edwardatki/Quectowatch/STM32WB55/Frontlight/jlcpcb/production_files/BOM-Frontlight.csv

Comment | Designator | Footprint | LCSC
LED | D1,D2 | LED_0603_1608Metric | C2290
27R | R1 | R_0603_1608Metric | C23140
