edwardatki/Quectowatch/STM32WB55/cover.step

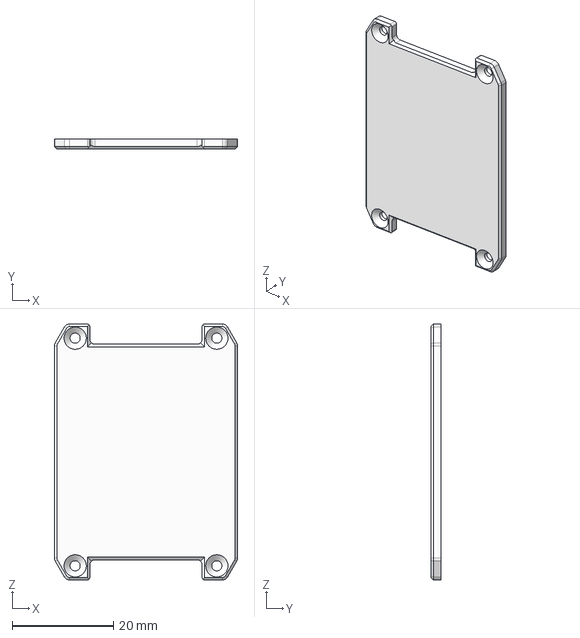
[picture p1: CAD file, 2024-08-24]
STM32WB55/cover.step
36.2 x 2.00 x 50.6 mm
