edwardatki/Quectowatch/STM32WB55/Frontlight/Frontlight.step

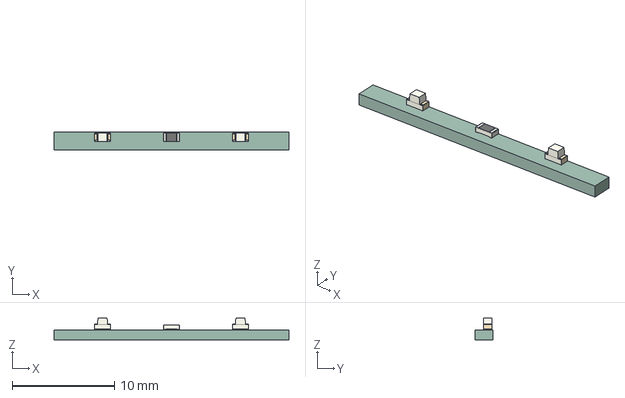
[picture p2: CAD file, 2024-08-17]
STM32WB55/Frontlight/Frontlight.step
23.0 x 1.75 x 2.13 mm
PCB
