edwardatki/Quectowatch/STM32WB55/Hardware/Hardware.step

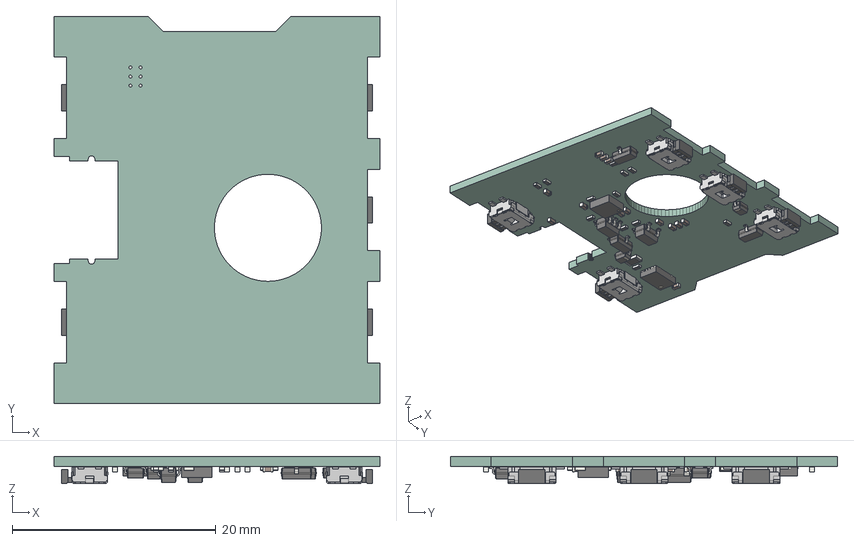
[picture p3: CAD file, 2024-08-17]
STM32WB55/Hardware/Hardware.step
32.0 x 38.0 x 2.68 mm
PCB
