edwardatki/Quectowatch/STM32WB55/case.step

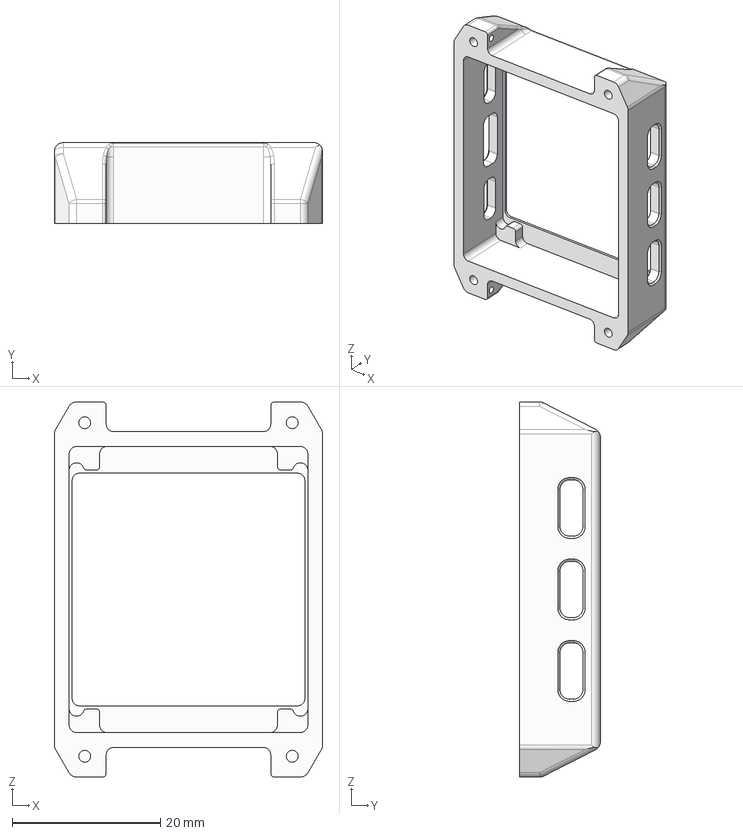
[picture p4: CAD file, 2024-08-24]
STM32WB55/case.step
36.2 x 10.9 x 50.6 mm
