edwardatki/Quectowatch/STM32WB55/button.step

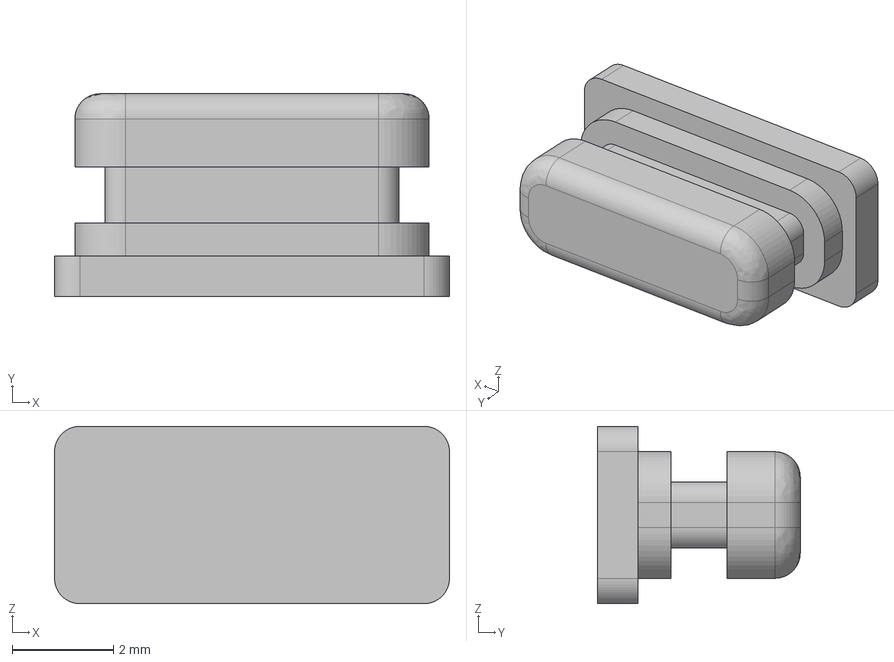
[picture p5: CAD file, 2024-08-17]
STM32WB55/button.step
7.80 x 4.00 x 3.50 mm
