edwardatki/Quectowatch/NRF52/Hardware/Hardware.step

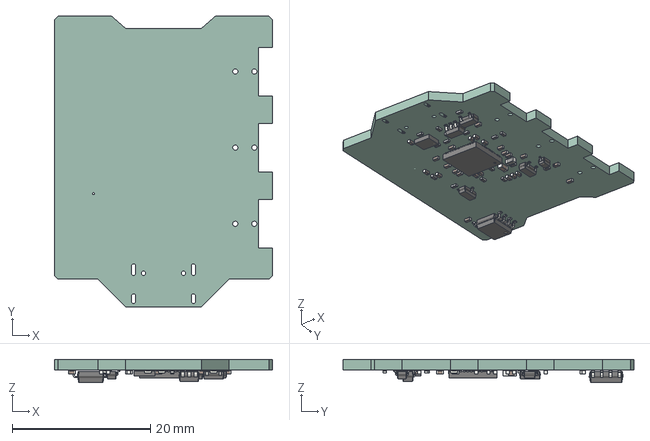
[picture p6: CAD file, 2024-04-19, an earlier design]
NRF52/Hardware/Hardware.step
31.5 x 42.0 x 3.38 mm
PCB
