edwardatki/Quectowatch/STM32WB55/drawing.pdf

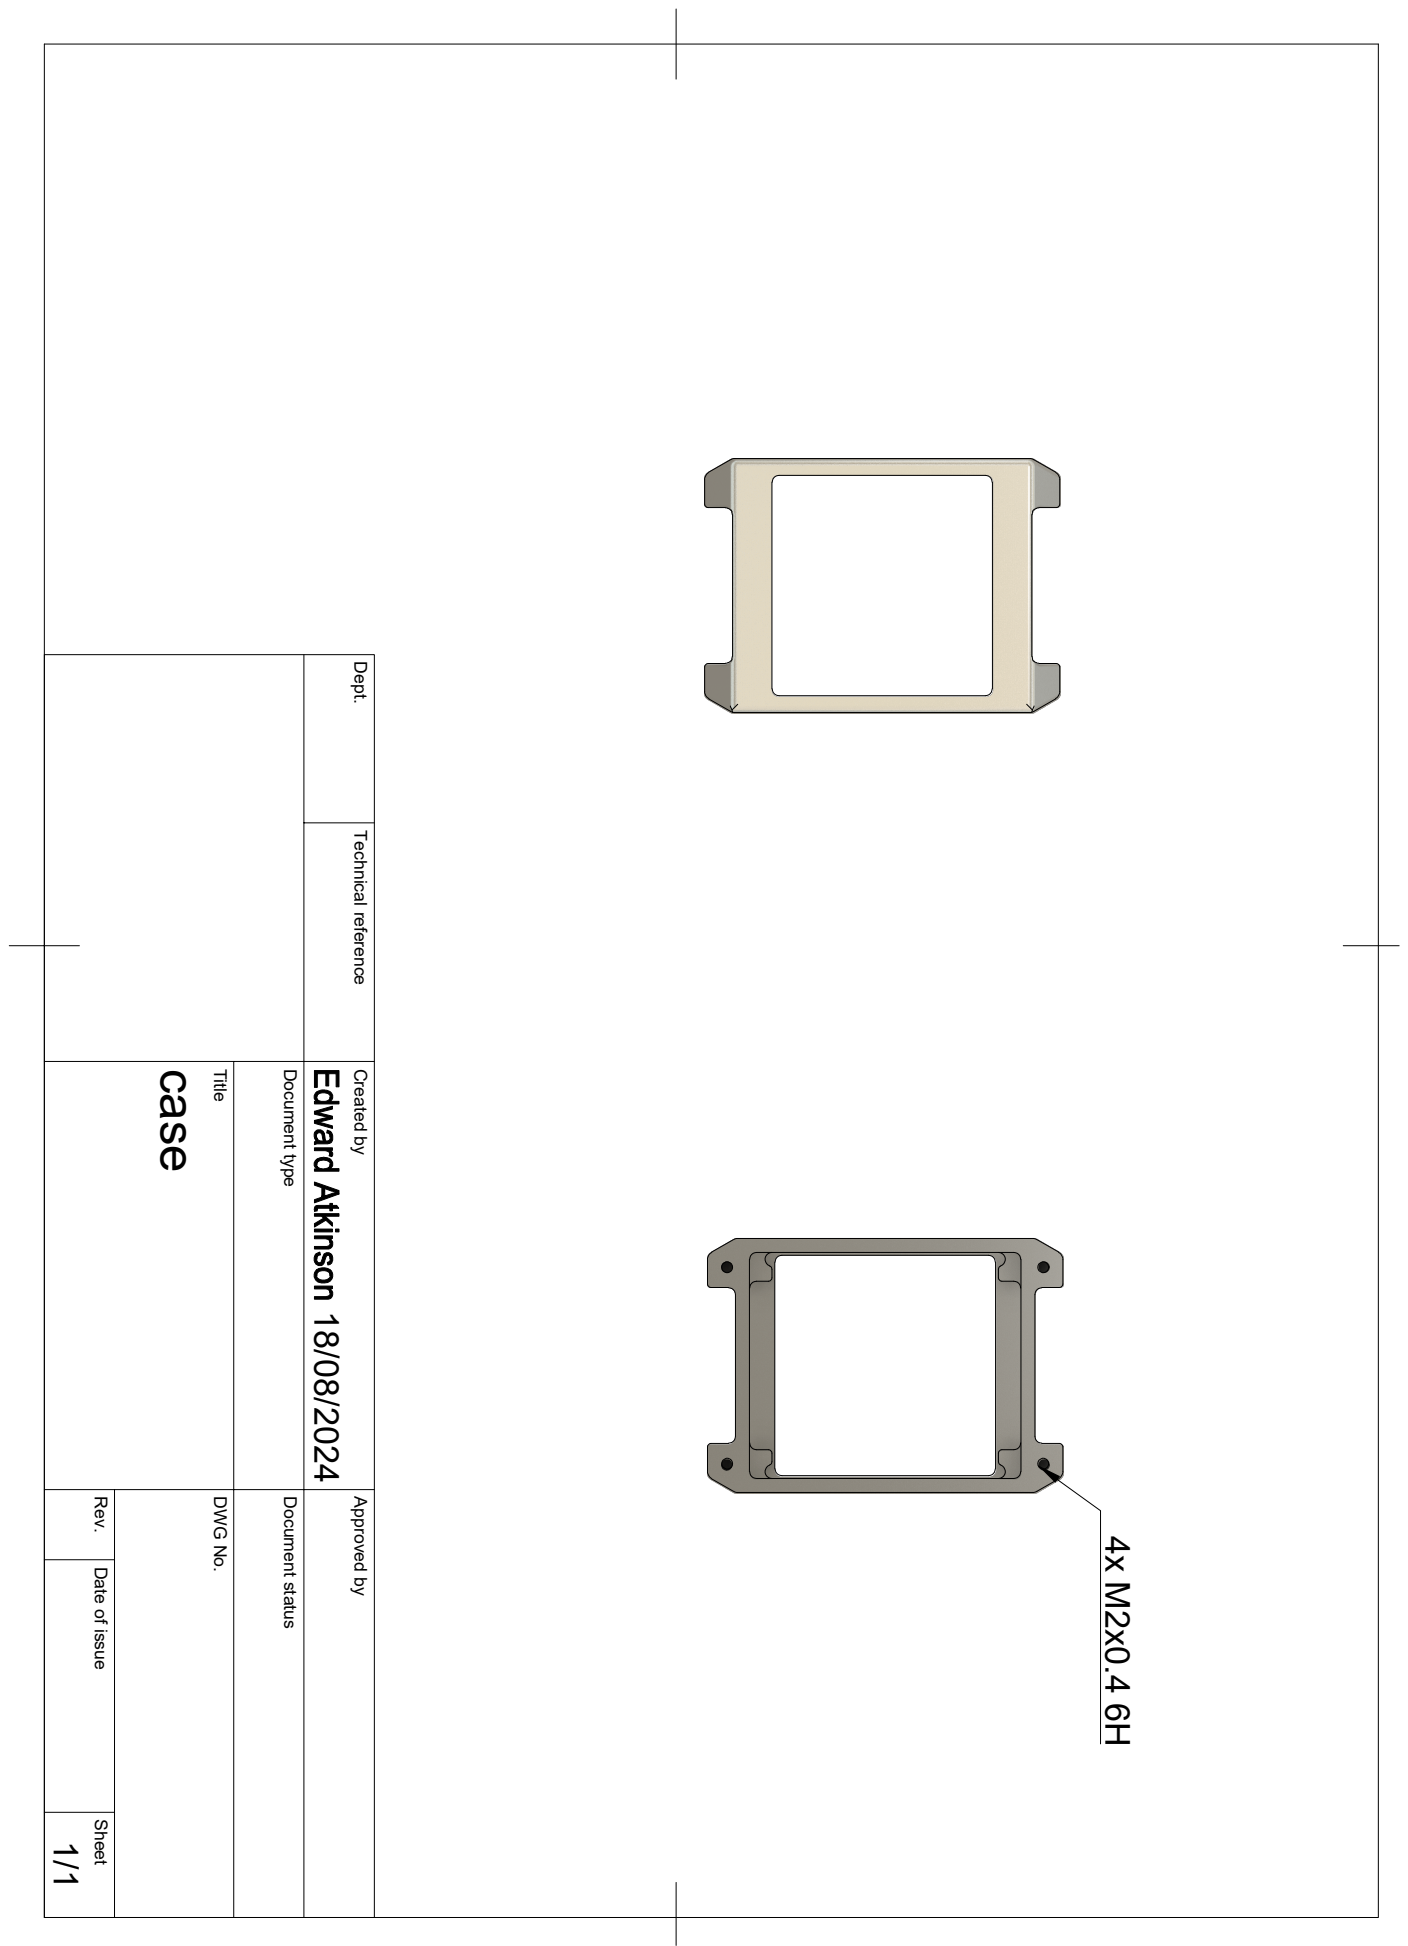
[picture p7: page 1]

Dept. Technical reference Created by Approved by Title DWG No. Document type Document status Rev. Date of issue Sheet 18/08/2024 1/1 case 4x M2x0.4 6H
