edwardatki/Quectowatch/STM32WB55/Hardware/Hardware.kicad_pcb

## KiCad design STM32WB55/Hardware/Hardware.kicad_pcb (2024-08-17)

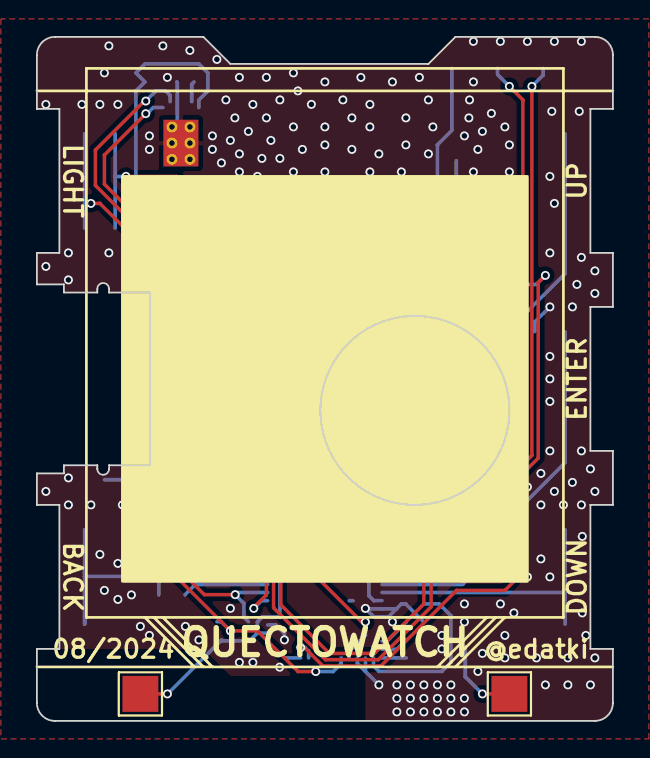
[picture p8: board STM32WB55/Hardware/Hardware.kicad_pcb from above]

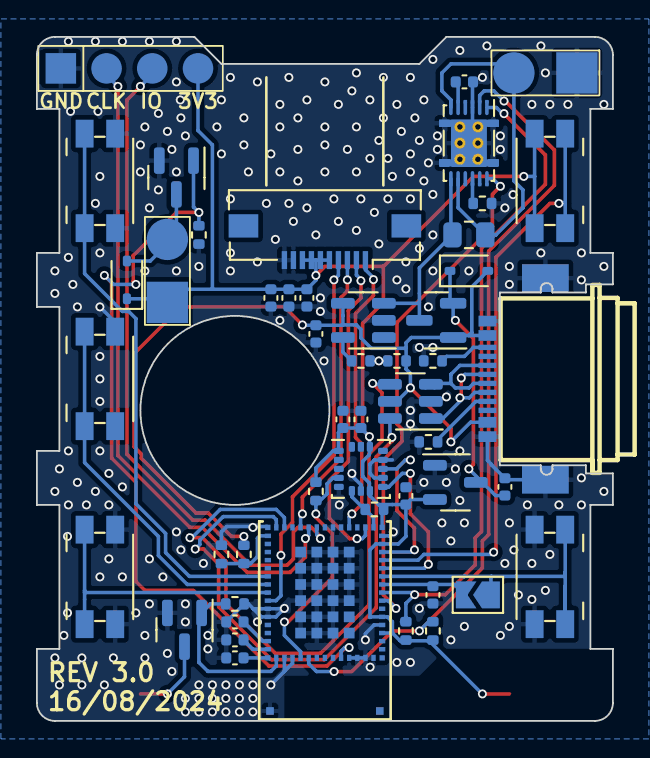
[picture p9: board STM32WB55/Hardware/Hardware.kicad_pcb from below]

Board: 2 copper layers, 32.0 x 38.0 mm, 51 parts (49 on the bottom side), 42 nets.

Parts:
C1, C7, C11: 100nF; C_0402_1005Metric
C2, C3, C4: 3.3pF; C_0402_1005Metric
C5: 470nF; C_0402_1005Metric
C6, C8, C9, C10, C13: 1uF; C_0402_1005Metric
C12: 10uF; C_0402_1005Metric
D1, D4: 1N5819WS; D_SOD-323
J1: USB_C_Receptacle_USB2.0; USB-C-SMD_SHOUHAN_TYPE-C-16PFS-2JCB1.2-H6.5
J2: PROG; 1x04_2.54_Pads
J3: BAT; 1x02_2.54_Pads
J4: LCD; Molex_54548-1071_1x10-1MP_P0.5mm_Horizontal
J5: AUX; 1x02_2.54_Pads
J6: LED+; TestPoint_Pad_2.0x2.0mm
J7: LED-; TestPoint_Pad_2.0x2.0mm
JP1: Jumper_2_Open; SolderJumper-2_P1.3mm_Open_TrianglePad1.0x1.5mm
Q1: AO3401A; SOT-23
Q2, Q3: AO3400A; SOT-23
R1, R2: 5K1; R_0402_1005Metric
R3: R01 1%; R_0805_2012Metric
R4: 470R; R_0402_1005Metric
R5: 1K; R_0402_1005Metric
R6, R7, R8, R10, R13, R14: 10K; R_0402_1005Metric
R9: 3.3K; R_0402_1005Metric
R12, R15: 100K; R_0402_1005Metric
SW1, SW2, SW3, SW4, SW5: SW_Push; Panasonic_EVQPUA_EVQPUJ
U1: USBLC6-2SC6; SOT-23-6
U2: STM32WB5MMGH6TR; LCC-LGA-86_L11.0-W7.3_STM32WB5MMGH6TR
U3: BQ27441DRZR-G1A; Texas_S-PDSO-N12
U4: TP4054; SOT-23-5
U5: LIS3DH; LGA-16_3x3mm_P0.5mm_LayoutBorder3x5y
U6: XC6206P332MR; SOT-23-3

Connections:
+3V3: C7.1, C8.1, C9.1, C11.1, C12.1, C13.1, D4.1 (K), J2.4, J4.5, J4.6, J4.7, J4.8, J5.1, J6.1, R7.1, R8.1, R13.1, R14.1, SW1.2, U2.4 (VREF+), U2.6 (VDDA), U2.15 (VBAT), U2.17 (VDDA), U5.1 (VDD_IO), U5.8 (CS), U5.14 (VDD), U6.2 (VO)
+BATT: Q1.3 (D), R3.2, U3.7 (SRN), U4.3 (BAT)
/AUX_EN: Q3.1 (G), R15.1, U2.56 (PA3)
/FG_INT: U2.8 (PC2), U3.12 (GPOUT)
/FG_SCL: R8.2, U2.52 (PA7), U3.2 (SCL)
/FG_SDA: R7.2, U2.9 (PC1), U3.1 (SDA)
/IMU_INT1: U2.14 (PB8), U5.11 (INT1)
/IMU_INT2: U2.12 (PC0), U5.9 (INT2)
/IMU_SCL: R14.2, U2.51 (PA9), U5.4 (SCL/SPC)
/IMU_SDA: R13.2, U2.18 (PB7), U5.6 (SDA/SDI/SDO)
/LCD_CS: J4.3, U2.27 (PA15)
/LCD_REFRESH: J4.4, U2.40 (PC13)
/LCD_SCLK: J4.1, U2.21 (PB3)
/LCD_SDI: J4.2, U2.19 (PB5)
/LIGHT_EN: Q2.1 (G), R12.1, U2.48 (PB2)
/SWDCLK: J2.2, U2.26 (PA14)
/SWDIO: J2.3, U2.25 (PA13)
/SW_LIGHT: SW1.1, U2.13 (PH3-BOOT0)
/USB_DN: U1.6 (I/O1), U2.30 (PA11)
/USB_DP: U1.4 (I/O2), U2.29 (PA12)
/~SW_DOWN: SW5.1, U2.39 (PB6)
/~SW_MENU: SW4.1, U2.38 (PB15)
/~SW_RESET: JP1.1 (A), SW2.1, U2.11 (PB9)
/~SW_UP: SW3.1, U2.37 (PB14)
GND: C1.2, C2.2, C3.2, C4.2, C5.2, C6.2, C7.2, C8.2, C9.2, C10.1, C11.2, C12.2, C13.2, J1.A1 (GND), J1.A12 (GND), J1.B1 (GND), J1.B12 (GND), J1.S1 (SHIELD), J2.1, J3.1, J4.9, J4.10, Q2.2 (S), Q3.2 (S), R1.2, R2.2, R5.1, R6.2, R9.1, R10.1, R12.2, R15.2, SW2.2, SW3.2, SW4.2, SW5.2, U1.2 (GND), U2.5 (VSS), U2.16 (VSS), U2.22 (PC10), U2.23 (PC11), U2.24 (PC12), U2.31 (VSS), U2.41 (PB12), U2.42 (PE4), U2.49 (PC4), U2.50 (PA8), U2.57 (VSS), U2.58 (ANT_IN), U2.59 (RF_OUT), U2.60 (VSS), U2.63 (PD14), U2.64 (PE1), U2.65 (PD13), U2.66 (PD12), U2.67 (PD7), U2.68 (PD2), U2.69 (PC9), U2.70 (PD3), U2.71 (PC7), U2.72 (PE3), U2.73 (PD4), U2.74 (PD9), U2.75 (PD8), U2.76 (PD15), U2.77 (PD10), U2.78 (PE2), U2.79 (PE0), U2.80 (PD5), U2.81 (PD6), U2.82 (PD11), U2.83 (PC8), U2.84 (VSS), U2.86 (VSS), U3.3 (V_{SS}), U3.13 (PAD), U4.2 (GND), U5.5 (GND), U5.7 (SDO/SA0), U5.10 (GND), U5.12 (GND), U6.1 (GND)
unnamed: J3.2, R3.1, U3.6 (BAT), U3.8 (SRP)
unnamed: R4.2, R5.2, U2.32 (VDDUSB)
unnamed: C10.2, D1.1 (K), Q1.2 (S), U6.3 (VI)
unnamed: D4.2 (A), J5.2, Q3.3 (D)
unnamed: J1.A5 (CC1), R2.1
unnamed: J1.B5 (CC2), R1.1
unnamed: J1.A6 (D+), J1.B6 (D+), U1.3 (I/O2)
unnamed: J1.A7 (D-), J1.B7 (D-), U1.1 (I/O1)
unnamed: J7.1, Q2.3 (D)
unnamed: C1.1, JP1.2 (B), U2.10 (NRST)
unnamed: C4.1, U2.47 (PB10)
unnamed: C3.1, U2.46 (PB11)
unnamed: C2.1, U2.45 (PC5)
unnamed: R6.1, U3.10 (BIN)
unnamed: C5.1, U3.5 (V_{DD})
unnamed: R9.2, U4.5 (PROG)
VBUS: C6.1, D1.2 (A), J1.A4 (VBUS), J1.A9 (VBUS), J1.B4 (VBUS), J1.B9 (VBUS), Q1.1 (G), R4.1, R10.2, U1.5 (VBUS), U4.4 (VCC)
