edwardatki/Quectowatch/STM32WB55/Frontlight/Frontlight.kicad_pcb

## KiCad design STM32WB55/Frontlight/Frontlight.kicad_pcb (2024-08-17)

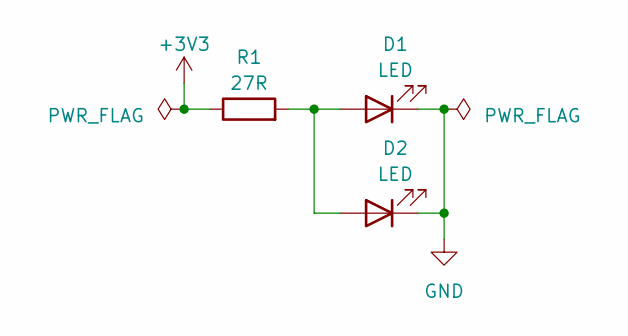
[picture p10: schematic Frontlight.kicad_sch]

Parts:
D1, D2: LED; LED_0603_1608Metric; LCSC C2290
R1: 27R; R_0603_1608Metric; LCSC C23140

Connections:
+3V3: R1.1
GND: D1.1 (K), D2.1 (K)
unnamed: D1.2 (A), D2.2 (A), R1.2

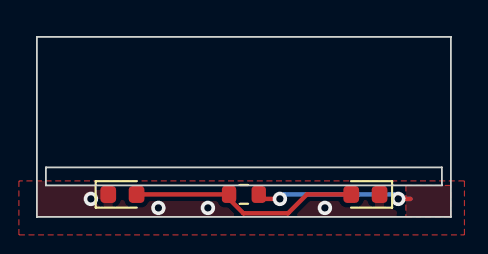
[picture p11: board Frontlight.kicad_pcb from above]

Board: 2 copper layers, 23.0 x 10.0 mm, 3 parts (0 on the bottom side), 2 nets.
