edwardatki/Quectowatch/NRF52/Hardware/Hardware.kicad_pcb

## KiCad design NRF52/Hardware/Hardware.kicad_pcb (2024-07-22, an earlier design)

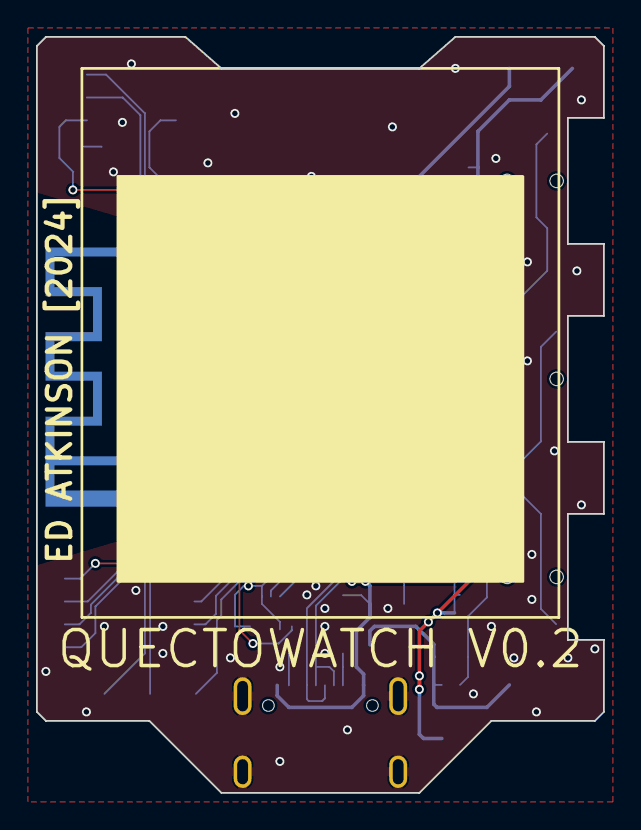
[picture p12: board NRF52/Hardware/Hardware.kicad_pcb from above]

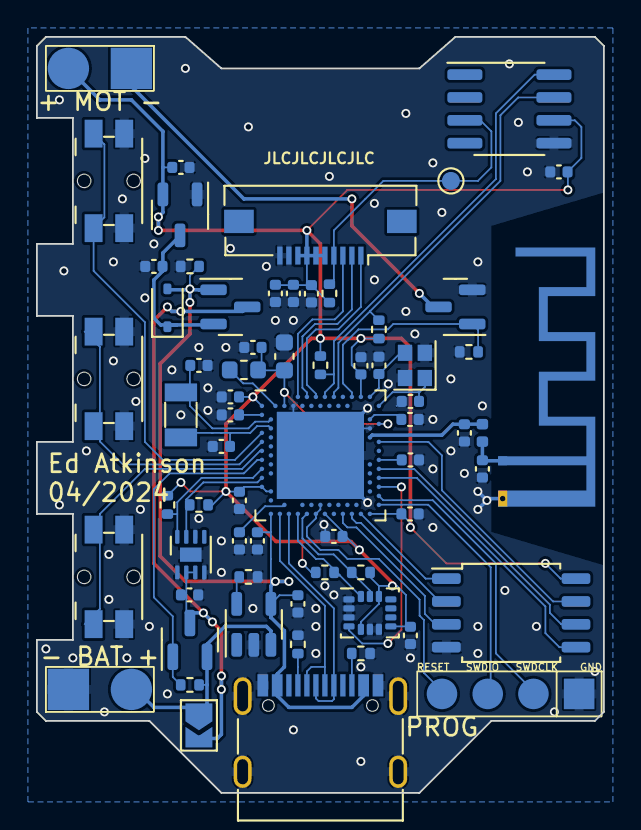
[picture p13: board NRF52/Hardware/Hardware.kicad_pcb from below]

Board: 2 copper layers, 31.5 x 42.0 mm, 66 parts (66 on the bottom side), 49 nets.

Parts:
AE1: Antenna_PCB; Texas_SWRA117D_2.4GHz_Left
C1, C12, C21, C22, C31, C34, C35, C36, C37: 1u; C_0402_1005Metric
C2, C3: 12p; C_0402_1005Metric
C4: 47n; C_0603_1608Metric
C5: 820p; C_0402_1005Metric
C6: 0p5; C_0402_1005Metric
C7, C20: 100p; C_0402_1005Metric
C8, C14, C15, C18, C19: 100n; C_0402_1005Metric
C9: 0p8; C_0402_1005Metric
C10, C11, C13: 4u7; C_0402_1005Metric
C16, C17: 6p8; C_0402_1005Metric
D1: 1N5819WS; D_SOD-323
J1: USB_C_Receptacle_USB2.0; USB_C_Receptacle_G-Switch_GT-USB-7010ASV
J2: LCD; Molex_54548-1071_1x10-1MP_P0.5mm_Horizontal
J3: PROG; Program_Pads
J4: BAT; Battery Pads
J5: MOTOR; Battery Pads
JP1: SolderJumper_2_Open; SolderJumper-2_P1.3mm_Open_TrianglePad1.0x1.5mm
L1: 4n7; L_0402_1005Metric
L3: 15u; L_0603_1608Metric
Q1, Q4: AO3401A; SOT-23
Q2: AO3400A; SOT-23
R1, R2: 5K1; R_0402_1005Metric
R3, R4, R6, R7, R8, R14, R15: 10K; R_0402_1005Metric
R5, R10, R11: 100K; R_0402_1005Metric
R9: 2K2; R_0402_1005Metric
SW1, SW2, SW3: SW_Push; Panasonic_EVQPUL_EVQPUC
TP2: LCD_REFRESH; TestPoint_Pad_D1.0mm
U1: nRF52840; Nordic_AQFN-73-1EP_7x7mm_P0.5mm
U2: TP4054; SOT-23-5
U3: MAX17048; TDFN-8-1EP_2x2mm_P0.5mm_EP0.8x1.2mm
U4: XC6206PxxxMR; SOT-23-3
U5: LSM6DS3; LGA-14_3x2.5mm_P0.5mm_LayoutBorder3x4y
U6: DS3231MZ; SOIC-8_3.9x4.9mm_P1.27mm
U7: W25Q128JVS; SOIC-8_5.23x5.23mm_P1.27mm
Y1: 32MHz 8pF ±10ppm; Crystal_SMD_2016-4Pin_2.0x1.6mm
Y2: 32.768kHz 6pF ±20ppm; Crystal_SMD_3215-2Pin_3.2x1.5mm

Connections:
+3V3: C12.1, C13.1, C14.1, C15.1, C18.1, C20.1, C21.1, C22.1, C35.1, C36.1, C37.1, J2.5, J2.6, J2.7, J2.8, J5.2, R4.1, R5.1, R6.1, R7.1, R8.1, R14.1, R15.1, U1.A22 (VDD), U1.AD14 (VDD), U1.AD23 (VDD), U1.B1 (VDD), U1.W1 (VDD), U1.Y2 (VDDH), U4.2 (VO), U5.5 (VDDIO), U5.8 (VDD), U5.12 (CS), U6.6 (VBAT), U7.8 (VCC)
+BATT: C19.1, JP1.2 (B), Q1.3 (D), Q4.3 (D), U3.2 (CELL), U3.3 (VDD)
/DOWN_BUTTON: SW3.1, U1.L1 (P0.06)
/FG_SCL: R8.2, U1.U1 (TRACEDATA1/P0.12), U3.7 (SCL)
/FG_SDA: R7.2, U1.R1 (TRACEDATA3/P1.09), U3.8 (SDA)
/IMU_INT: U1.W24 (P1.02), U5.4 (INT1)
/IMU_SCL: R6.2, U1.AD10 (P0.15), U5.13 (SCL)
/IMU_SDA: R4.2, U1.AD8 (P0.13), U5.14 (SDA)
/LCD_CS: J2.3, U1.A8 (AIN7/P0.31)
/LCD_REFRESH: J2.4, R5.2, TP2.1, U6.3 (~INT/SQW)
/LCD_SCLK: J2.1, U1.A12 (AIN0/P0.02)
/LCD_SDI: J2.2, U1.A10 (AIN5/P0.29)
/MENU_BUTTON: SW1.1, U1.J1 (AIN2/P0.04)
/MOTOR_EN: Q2.1 (G), R11.1, U1.A20 (P1.10)
/POWER_LATCH: Q4.1 (G), R10.1, U1.N1 (P0.08)
/QSPI_CS: U1.AD22 (TRACEDATA0/P1.00), U7.1 (~CS)
/QSPI_D0: U1.U24 (P1.04), U7.5 (DI(IO0))
/QSPI_D1: U1.AD20 (P0.24), U7.2 (DO(IO1))
/QSPI_D2: U1.AD18 (P0.22), U7.3 (IO2)
/QSPI_D3: U1.J24 (NFC2/P0.10), U7.7 (IO3)
/QSPI_SCK: U1.R24 (P1.06), U7.6 (CLK)
/RTC_SCL: R15.2, U1.A16 (P1.13), U6.7 (SDA)
/RTC_SDA: R14.2, U1.A14 (P1.15), U6.8 (SCL)
/SWDCLK: J3.2, U1.AA24 (SWDCLK)
/SWDIO: J3.3, U1.AC24 (SWDIO)
/UP_BUTTON: SW2.1, U1.G1 (P0.26)
/USB_DN: J1.A7 (D-), J1.B7 (D-), U1.AD4 (D-)
/USB_DP: J1.A6 (D+), J1.B6 (D+), U1.AD6 (D+)
/~RESET: J3.4, U1.AC13 (P0.18/~RESET), U1.AD12 (P0.17)
GND: AE1.2 (PCB_Trace), C1.2, C2.1, C3.2, C4.2, C5.2, C6.2, C7.2, C8.2, C9.2, C10.2, C11.2, C12.2, C13.2, C14.2, C15.2, C16.1, C17.2, C18.2, C19.2, C20.2, C21.2, C22.2, C31.2, C34.1, C35.2, C36.2, C37.2, J1.A1 (GND), J1.A12 (GND), J1.B1 (GND), J1.B12 (GND), J1.S1 (SHIELD), J2.9, J2.10, J3.1, J4.1, Q2.2 (S), R1.2, R2.2, R3.1, R9.1, R11.2, SW1.2, SW2.2, SW3.2, U1.B7 (VSS), U1.EP (VSS), U1.F23 (VSS_PA), U2.2 (GND), U3.1 (CTG), U3.4 (GND), U3.6 (QSTRT), U3.9 (GND), U4.1 (GND), U5.1 (SDO/SA0), U5.2 (SDX), U5.3 (SCX), U5.6 (GND), U5.7 (GND), U6.5 (GND), U7.4 (GND), Y1.2, Y1.4
unnamed: C34.2, D1.1 (K), Q1.2 (S), U4.3 (VI)
unnamed: J4.2, JP1.1 (A), Q4.2 (S), R10.2, U2.3 (BAT)
unnamed: AE1.1 (FEED), C6.1, L1.1
unnamed: J1.A5 (CC1), R2.1
unnamed: J1.B5 (CC2), R1.1
unnamed: J5.1, Q2.3 (D)
unnamed: C9.1, L1.2, U1.H23 (ANT)
unnamed: L3.2, U1.B3 (DCC)
unnamed: C8.1, U1.C1 (DEC1)
unnamed: C7.1, U1.D23 (DEC3)
unnamed: C1.1, C4.1, L3.1, U1.B5 (DEC4), U1.E24 (DEC6)
unnamed: C5.1, U1.N24 (DEC5)
unnamed: C10.1, U1.AC5 (DECUSB)
unnamed: C2.2, U1.B24 (XC1), Y1.1
unnamed: C3.1, U1.A23 (XC2), Y1.3
unnamed: C16.2, U1.D2 (XL1/P0.00), Y2.2
unnamed: C17.1, U1.F2 (XL2/P0.01), Y2.1
unnamed: R9.2, U2.5 (PROG)
VBUS: C11.1, C31.1, D1.2 (A), J1.A4 (VBUS), J1.A9 (VBUS), J1.B4 (VBUS), J1.B9 (VBUS), Q1.1 (G), R3.2, U1.AD2 (VBUS), U2.4 (VCC)
