edwardatki/Quectowatch/ESP32/Hardware/Hardware.kicad_pcb

## KiCad design ESP32/Hardware/Hardware.kicad_pcb (2024-01-11, an earlier design)

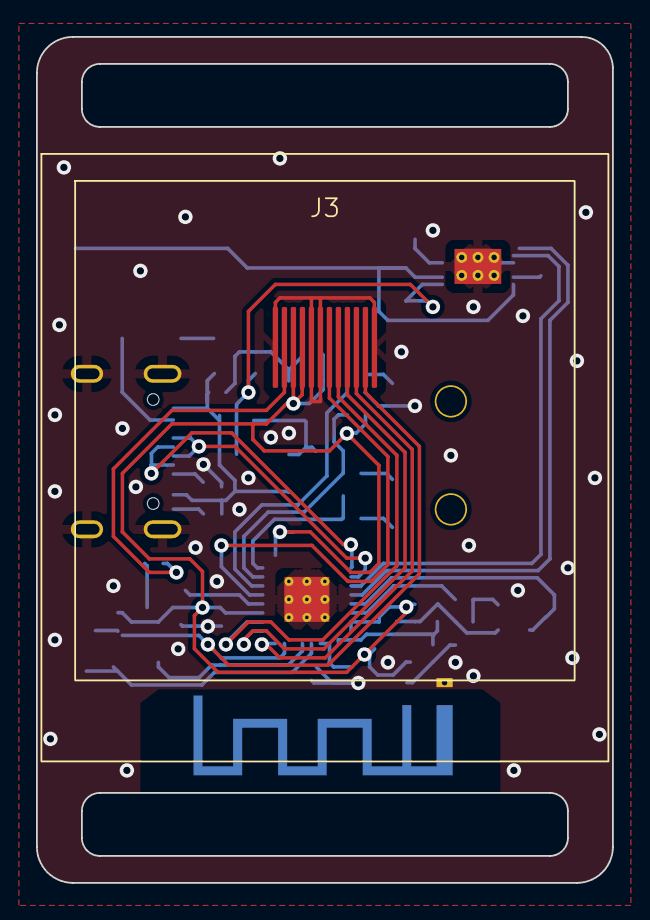
[picture p14: board ESP32/Hardware/Hardware.kicad_pcb from above]

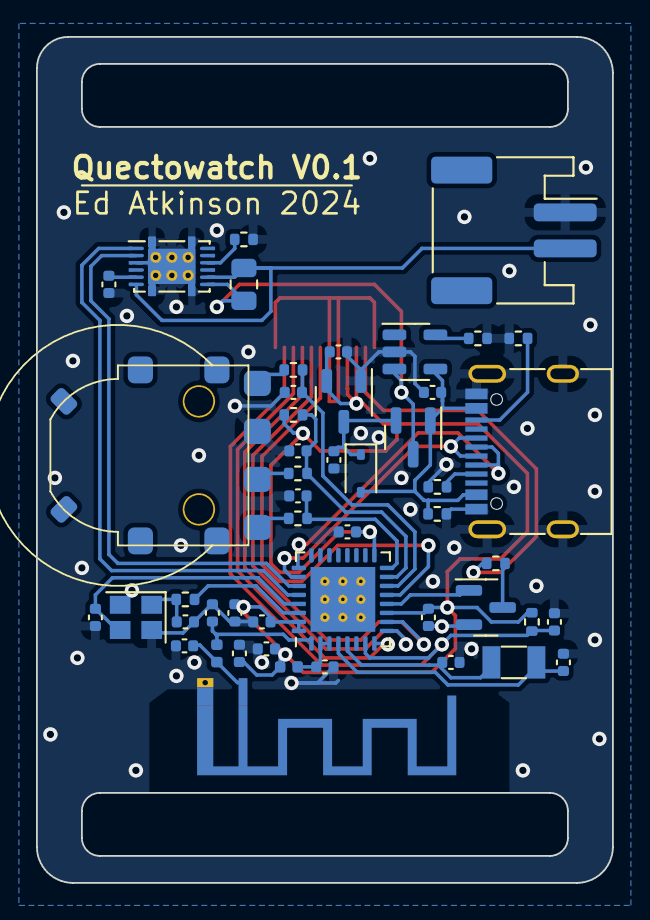
[picture p15: board ESP32/Hardware/Hardware.kicad_pcb from below]

Board: 2 copper layers, 32.0 x 47.0 mm, 50 parts (49 on the bottom side), 37 nets.

Parts:
AE1: Antenna_PCB; Texas_SWRA117D_2.4GHz_Left
C1, C2: 12p; C_0402_1005Metric
C3, C4: 6p8; C_0402_1005Metric
C5: 10u; C_0402_1005Metric
C6, C11, C15, C16, C17: 1u; C_0402_1005Metric
C7, C8, C9, C10: 100n; C_0402_1005Metric
C12, C20, C21, C22: 10n; C_0402_1005Metric
C13, C19: 3p3; C_0402_1005Metric
C14: 470n; C_0402_1005Metric
D1: 1N5819WS; D_SOD-323
J1: USB_C_Receptacle_USB2.0; USB_C_Receptacle_G-Switch_GT-USB-7010ASV
J2: Battery; JST_PH_S2B-PH-SM4-TB_1x02-1MP_P2.00mm_Horizontal
J3: ST7789 1.54" LCD; 1.54 ST7789
J4: SIQ-02FVS3
L1, L2: 2n2; L_0402_1005Metric
Q1: AO3401A; SOT-23
Q2: AO3400A; SOT-23
R1, R5, R7, R10, R11, R12, R13: 10K; R_0402_1005Metric
R2: 22R; R_0402_1005Metric
R3, R4: 5K1; R_0402_1005Metric
R6: R01 1%; R_0805_2012Metric
R8: 2K2; R_0402_1005Metric
R9: 10R; R_0402_1005Metric
U1: ESP32-C3FH4AZ; QFN-32-1EP_5x5mm_P0.5mm_EP3.6x3.6mm_ThermalVias
U2: BQ27441DRZR-G1A; Texas_S-PDSO-N12
U3: TP4054; SOT-23-5
U4: XC6206PxxxMR; SOT-23-3
Y1: 40MHz 9pF ±10ppm; Crystal_SMD_2520-4Pin_2.5x2.0mm
Y2: 32.768kHz 6pF ±20ppm; Crystal_SMD_3215-2Pin_3.2x1.5mm

Connections:
+3V3: C5.1, C7.1, C9.1, C10.1, C11.1, C12.1, C17.1, J3.3, J3.4, L1.1, R1.1, R5.1, U1.11 (VDD3P3_RTC), U1.17 (VDD3P3_CPU), U1.31 (VDDA), U1.32 (VDDA), U4.2 (VO)
+BATT: Q1.3 (D), R6.2, U2.7 (SRN), U3.3 (BAT)
/ENC_A: C20.1, R11.1, U1.16 (IO10)
/ENC_B: C22.1, R13.1, U1.14 (IO8)
/ENC_SW: C21.1, R5.2, R12.1, U1.15 (BOOT/IO9)
/LCD_BL: Q2.1 (G), U1.12 (MTCK/IO6)
/LCD_BL_K: J3.2, R9.1
/LCD_CS: J3.8, U1.10 (MTDI/ADC2_CH20/IO5)
/LCD_DC: J3.7, U1.13 (MTDO/IO7)
/LNA_IN: C13.1, L2.1, U1.1 (LNA_IN)
/MOSI: J3.10, U1.8 (ADC1_CH3/IO3)
/SCK: J3.9, U1.9 (MTMS/ADC1_CH4/IO4)
/SCL: U1.27 (U0RXD/IO20), U2.2 (SCL)
/SDA: U1.28 (U0TXD/IO21), U2.1 (SDA)
/USB_DN: J1.A7 (D-), J1.B7 (D-), U1.25 (USB_DN/IO18)
/USB_DP: J1.A6 (D+), J1.B6 (D+), U1.26 (USB_DP/IO19)
/~RESET: C6.1, J3.11, R1.2, U1.7 (CHIP_EN)
GND: AE1.2 (PCB_Trace), C1.1, C2.2, C3.1, C4.2, C5.2, C6.2, C7.2, C8.2, C9.2, C10.2, C11.2, C12.2, C13.2, C14.2, C15.2, C16.2, C17.2, C19.2, C20.2, C21.2, C22.2, J1.A1 (GND), J1.A12 (GND), J1.B1 (GND), J1.B12 (GND), J1.S1 (SHIELD), J2.1, J3.1, J3.5, J3.6, J3.12, J4.3, Q2.2 (S), R3.1, R4.2, R7.2, R8.1, R10.1, U1.33 (GND), U2.3 (V_{SS}), U2.13 (PAD), U3.2 (GND), U4.1 (GND), Y1.2, Y1.4
unnamed: AE1.1 (FEED), C19.1, L2.2
unnamed: C1.2, R2.1, Y1.1
unnamed: C8.1, L1.2, U1.2 (VDD3P3), U1.3 (VDD3P3)
unnamed: C16.1, D1.1 (K), Q1.2 (S), U4.3 (VI)
unnamed: J1.A5 (CC1), R4.1
unnamed: J1.B5 (CC2), R3.2
unnamed: J2.2, R6.1, U2.6 (BAT), U2.8 (SRP)
unnamed: J4.1, R11.2
unnamed: J4.2, R12.2
unnamed: J4.4, R13.2
unnamed: Q2.3 (D), R9.2
unnamed: C4.1, U1.5 (XTAL_32K_N/ADC1_CH1/IO1), Y2.1
unnamed: C3.2, U1.4 (XTAL_32K_P/ADC1_CH0/IO0), Y2.2
unnamed: C2.1, U1.29 (XTAL_N), Y1.3
unnamed: R2.2, U1.30 (XTAL_P)
unnamed: R7.1, U2.10 (BIN)
unnamed: C14.1, U2.5 (V_{DD})
unnamed: R8.2, U3.5 (PROG)
VBUS: C15.1, D1.2 (A), J1.A4 (VBUS), J1.A9 (VBUS), J1.B4 (VBUS), J1.B9 (VBUS), Q1.1 (G), R10.2, U3.4 (VCC)
