edwardatki/Quectowatch/STM32WB55/Firmware/Core/Src/main.c

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
/* Includes ------------------------------------------------------------------*/
#include "main.h"
#include "i2c.h"
#include "lptim.h"
#include "memorymap.h"
#include "rtc.h"
#include "spi.h"
#include "usb.h"
#include "gpio.h"

/* USER CODE BEGIN Includes */
#include "lcd.h"
#include "bq27441.h"
#include "sleep.h"
/* USER CODE END Includes */


/* USER CODE BEGIN PV */
uint8_t up_just_pressed = 0;
uint8_t menu_just_pressed = 0;
uint8_t down_just_pressed = 0;

uint32_t up_press_start_timestamp;
uint32_t menu_press_start_timestamp;
uint32_t down_press_start_timestamp;

uint8_t should_sleep = 1;
/* USER CODE END PV */

void SystemClock_Config(void);
void PeriphCommonClock_Config(void);
/* USER CODE BEGIN 0 */
void HAL_GPIO_EXTI_Callback(uint16_t GPIO_Pin) {
	uint32_t current_timestamp = HAL_GetTick();

	if (GPIO_Pin == GPIO_PIN_14) { // UP
		if ((current_timestamp - up_press_start_timestamp) > 200) {
			up_just_pressed = 1;
			up_press_start_timestamp = current_timestamp;
		}
	} else if(GPIO_Pin == GPIO_PIN_15) { // MENU
		if ((current_timestamp - menu_press_start_timestamp) > 200) {
			menu_just_pressed = 1;
			menu_press_start_timestamp = current_timestamp;
		}
	} else if (GPIO_Pin == GPIO_PIN_6) { // DOWN
		if ((current_timestamp - down_press_start_timestamp) > 200) {
			down_just_pressed = 1;
			down_press_start_timestamp = current_timestamp;
		}
	} else if (GPIO_Pin == GPIO_PIN_3) { // LIGHT
		if (HAL_GPIO_ReadPin(SW_LIGHT_GPIO_Port, SW_LIGHT_Pin)) {
			HAL_LPTIM_PWM_Start(&hlptim1, 100, 50);
		} else {
			HAL_LPTIM_PWM_Stop(&hlptim1);
		}
	}
}

static int16_t BQ27441_i2cWriteBytes(uint8_t DevAddress, uint8_t subAddress, uint8_t * src, uint8_t count)
{
    if (HAL_I2C_Mem_Write(&hi2c3, (uint16_t)(DevAddress << 1), subAddress, 1, src, count, 50) == HAL_OK)
        return true;
    else
        return false;
}

static int16_t BQ27441_i2cReadBytes(uint8_t DevAddress, uint8_t subAddress, uint8_t * dest, uint8_t count)
{
    if (HAL_I2C_Mem_Read(&hi2c3, (uint16_t)(DevAddress << 1), subAddress, 1, dest, count, 50) == HAL_OK)
        return true;
    else
        return false;
}

/* USER CODE END 0 */

/**
  * @brief  The application entry point.
  * @retval int
  */
int main(void)
{

  /* MCU Configuration--------------------------------------------------------*/

  /* Reset of all peripherals, Initializes the Flash interface and the Systick. */
  HAL_Init();

  /* Configure the system clock */
  SystemClock_Config();

  /* Configure the peripherals common clocks */
  PeriphCommonClock_Config();

  /* USER CODE BEGIN SysInit */
  sleep_init();
  /* USER CODE END SysInit */

  /* Initialize all configured peripherals */
  MX_GPIO_Init();
  MX_LPTIM1_Init();
  MX_RTC_Init();
  MX_I2C1_Init();
  MX_I2C3_Init();
  MX_SPI1_Init();
  MX_USB_PCD_Init();
  /* USER CODE BEGIN 2 */
  HAL_RTCEx_SetSmoothCalib(&hrtc, RTC_SMOOTHCALIB_PERIOD_32SEC, RTC_SMOOTHCALIB_PLUSPULSES_RESET, 160);

  static BQ27441_ctx_t BQ27441 = {
		  .BQ27441_i2c_address = BQ72441_I2C_ADDRESS, // i2c device address, if you have another address change this
		  .read_reg = BQ27441_i2cReadBytes,           // i2c read callback
		  .write_reg = BQ27441_i2cWriteBytes,         // i2c write callback
  };
  BQ27441_init(&BQ27441);
//  BQ27441_Full_Reset();
  BQ27441_enterConfig(1);
  BQ27441_setCapacity(500);
  BQ27441_setTerminateVoltageMin(3000);
  BQ27441_exitConfig(1);

  lcd_init();
  /* USER CODE END 2 */

  /* Infinite loop */
  /* USER CODE BEGIN WHILE */
  while (1)
  {
	uint32_t current_timestamp = HAL_GetTick();

	static uint8_t editing = 0;

	static bool just_switched = false;
	if (!HAL_GPIO_ReadPin(SW_MENU_GPIO_Port, SW_MENU_Pin) && ((current_timestamp - menu_press_start_timestamp) > 3000)) {
		if (!just_switched) {
			should_sleep = !should_sleep;
			editing = 0;
			just_switched = true;
		}
	} else {
		just_switched = false;
	}

	if (should_sleep) {
		up_just_pressed = false;
		menu_just_pressed = false;
		down_just_pressed = false;

		lcd_update(-1);
		enter_stop(200);
	} else {

		RTC_TimeTypeDef new_time = {0};
		RTC_DateTypeDef new_date = {0};
		HAL_RTC_GetTime(&hrtc, &new_time, RTC_FORMAT_BIN);
		HAL_RTC_GetDate(&hrtc, &new_date, RTC_FORMAT_BIN);

		 if (up_just_pressed) {
			 if (editing == 0) new_time.Hours = (uint16_t)((uint16_t)new_time.Hours + 1) % 24;
			 else if (editing == 1) new_time.Minutes = (uint16_t)((uint16_t)new_time.Minutes + 1) % 60;
			 else if (editing == 2) new_time.Seconds = (uint16_t)((uint16_t)new_time.Seconds + 1) % 60;
			 else if (editing == 3) new_date.WeekDay = (uint16_t)((uint16_t)new_date.WeekDay + 1)% 6;
			 else if (editing == 4) new_date.Date = (uint16_t)((uint16_t)new_date.Date % 31) + 1;
			 else if (editing == 5) new_date.Month = (uint16_t)((uint16_t)new_date.Month % 12) + 1;
			 else if (editing == 6) new_date.Year = (uint16_t)((uint16_t)new_date.Year + 1) % 100;

			up_just_pressed = false;
		 }

		 if (down_just_pressed) {
			 if (editing == 0) new_time.Hours = (uint16_t)((uint16_t)new_time.Hours - 1) % 24;
			 else if (editing == 1) new_time.Minutes = (uint16_t)((uint16_t)new_time.Minutes - 1) % 60;
			 else if (editing == 2) new_time.Seconds = (uint16_t)((uint16_t)new_time.Seconds - 1) % 60;
			 else if (editing == 3) new_date.WeekDay = (uint16_t)((uint16_t)new_date.WeekDay - 1) % 6;
			 else if (editing == 4) new_date.Date = (uint16_t)((uint16_t)new_date.Date - 1) % 32;
			 else if (editing == 5) new_date.Month = (uint16_t)((uint16_t)new_date.Month - 1) % 13;
			 else if (editing == 6) new_date.Year = (uint16_t)((uint16_t)new_date.Year - 1) % 100;

			 down_just_pressed = false;
		 }

		 if (menu_just_pressed) {
			 editing = (editing + 1) % 7;
			 menu_just_pressed = false;
		 }
		 HAL_RTC_SetTime(&hrtc, &new_time, RTC_FORMAT_BIN);
		 HAL_RTC_SetDate(&hrtc, &new_date, RTC_FORMAT_BIN);

		 lcd_update(editing);
	}
    /* USER CODE END WHILE */

    /* USER CODE BEGIN 3 */
  }
  /* USER CODE END 3 */
}

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
