edwardatki/Quectowatch/STM32WB55/Firmware/Firmware.ioc

Mcu.UserName=STM32WB55VGYx
PA11.Signal=USB_DM
PA12.Signal=USB_DP
PA13.Signal=SYS_JTMS-SWDIO
PA14.Signal=SYS_JTCK-SWCLK
PA15.GPIO_Label=LCD_CS
PA15.Signal=GPIO_Output
PA3.GPIO_Label=AUX_EN
PA3.Signal=GPIO_Output
PA7.GPIO_Label=FG_SCL
PA7.Signal=I2C3_SCL
PA9.GPIO_Label=IMU_SCL
PA9.Signal=I2C1_SCL
PB14.GPIO_Label=SW_UP
PB14.Signal=GPXTI14
PB15.GPIO_Label=SW_MENU
PB15.Signal=GPXTI15
PB2.GPIO_Label=LIGHT_EN
PB2.Signal=LPTIM1_OUT
PB3.GPIO_Label=LCD_SCK
PB3.Signal=SPI1_SCK
PB5.GPIO_Label=LCD_MOSI
PB5.Signal=SPI1_MOSI
PB6.GPIO_Label=SW_DOWN
PB6.Signal=GPXTI6
PB7.GPIO_Label=IMU_SDA
PB7.Signal=I2C1_SDA
PB8.GPIO_Label=IMU_INT1
PB8.Signal=GPIO_Input
PB9.GPIO_Label=SW_RESET
PB9.Signal=GPIO_Input
PC0.GPIO_Label=IMU_INT2
PC0.Signal=GPIO_Input
PC1.GPIO_Label=FG_SDA
PC1.Signal=I2C3_SDA
PC13.GPIO_Label=LCD_REFRESH
PC13.Signal=GPIO_Output
PC14-OSC32_IN.Signal=RCC_OSC32_IN
PC15-OSC32_OUT.Signal=RCC_OSC32_OUT
PC2.GPIO_Label=FG_INT
PC2.Signal=GPIO_Input
PH3-BOOT0.GPIO_Label=SW_LIGHT
PH3-BOOT0.Signal=GPXTI3
