edwardatki/Quectowatch/STM32WB55/Firmware/Core/Src/gpio.c

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

/* Includes ------------------------------------------------------------------*/
#include "gpio.h"

/*----------------------------------------------------------------------------*/
/* Configure GPIO                                                             */
/*----------------------------------------------------------------------------*/
/** Configure pins as
        * Analog
        * Input
        * Output
        * EVENT_OUT
        * EXTI
        * Free pins are configured automatically as Analog (this feature is enabled through
        * the Code Generation settings)
*/
void MX_GPIO_Init(void)
{

  GPIO_InitTypeDef GPIO_InitStruct = {0};

  /* GPIO Ports Clock Enable */
  __HAL_RCC_GPIOA_CLK_ENABLE();
  __HAL_RCC_GPIOC_CLK_ENABLE();
  __HAL_RCC_GPIOD_CLK_ENABLE();
  __HAL_RCC_GPIOB_CLK_ENABLE();
  __HAL_RCC_GPIOE_CLK_ENABLE();
  __HAL_RCC_GPIOH_CLK_ENABLE();

  /*Configure GPIO pin Output Level */
  HAL_GPIO_WritePin(GPIOA, LCD_CS_Pin|AUX_EN_Pin, GPIO_PIN_RESET);

  /*Configure GPIO pin Output Level */
  HAL_GPIO_WritePin(LCD_REFRESH_GPIO_Port, LCD_REFRESH_Pin, GPIO_PIN_RESET);

  /*Configure GPIO pins : PAPin PAPin */
  GPIO_InitStruct.Pin = LCD_CS_Pin|AUX_EN_Pin;
  GPIO_InitStruct.Mode = GPIO_MODE_OUTPUT_PP;
  GPIO_InitStruct.Pull = GPIO_NOPULL;
  GPIO_InitStruct.Speed = GPIO_SPEED_FREQ_LOW;
  HAL_GPIO_Init(GPIOA, &GPIO_InitStruct);

  /*Configure GPIO pins : PC10 PC9 PC11 PC12
                           PC6 PC7 PC8 PC4
                           PC3 PC5 */
  GPIO_InitStruct.Pin = GPIO_PIN_10|GPIO_PIN_9|GPIO_PIN_11|GPIO_PIN_12
                          |GPIO_PIN_6|GPIO_PIN_7|GPIO_PIN_8|GPIO_PIN_4
                          |GPIO_PIN_3|GPIO_PIN_5;
  GPIO_InitStruct.Mode = GPIO_MODE_ANALOG;
  GPIO_InitStruct.Pull = GPIO_NOPULL;
  HAL_GPIO_Init(GPIOC, &GPIO_InitStruct);

  /*Configure GPIO pins : PD2 PD7 PD5 PD12
                           PD3 PD1 PD0 PD6
                           PD13 PD4 PD8 PD9
                           PD14 PD10 PD11 PD15 */
  GPIO_InitStruct.Pin = GPIO_PIN_2|GPIO_PIN_7|GPIO_PIN_5|GPIO_PIN_12
                          |GPIO_PIN_3|GPIO_PIN_1|GPIO_PIN_0|GPIO_PIN_6
                          |GPIO_PIN_13|GPIO_PIN_4|GPIO_PIN_8|GPIO_PIN_9
                          |GPIO_PIN_14|GPIO_PIN_10|GPIO_PIN_11|GPIO_PIN_15;
  GPIO_InitStruct.Mode = GPIO_MODE_ANALOG;
  GPIO_InitStruct.Pull = GPIO_NOPULL;
  HAL_GPIO_Init(GPIOD, &GPIO_InitStruct);

  /*Configure GPIO pins : PA10 PA2 PA1 PA0
                           PA6 PA8 PA5 PA4 */
  GPIO_InitStruct.Pin = GPIO_PIN_10|GPIO_PIN_2|GPIO_PIN_1|GPIO_PIN_0
                          |GPIO_PIN_6|GPIO_PIN_8|GPIO_PIN_5|GPIO_PIN_4;
  GPIO_InitStruct.Mode = GPIO_MODE_ANALOG;
  GPIO_InitStruct.Pull = GPIO_NOPULL;
  HAL_GPIO_Init(GPIOA, &GPIO_InitStruct);

  /*Configure GPIO pins : PE1 PE0 PE2 PE4
                           PE3 */
  GPIO_InitStruct.Pin = GPIO_PIN_1|GPIO_PIN_0|GPIO_PIN_2|GPIO_PIN_4
                          |GPIO_PIN_3;
  GPIO_InitStruct.Mode = GPIO_MODE_ANALOG;
  GPIO_InitStruct.Pull = GPIO_NOPULL;
  HAL_GPIO_Init(GPIOE, &GPIO_InitStruct);

  /*Configure GPIO pins : PB13 PB4 PB12 PB1
                           PB0 PB11 PB10 */
  GPIO_InitStruct.Pin = GPIO_PIN_13|GPIO_PIN_4|GPIO_PIN_12|GPIO_PIN_1
                          |GPIO_PIN_0|GPIO_PIN_11|GPIO_PIN_10;
  GPIO_InitStruct.Mode = GPIO_MODE_ANALOG;
  GPIO_InitStruct.Pull = GPIO_NOPULL;
  HAL_GPIO_Init(GPIOB, &GPIO_InitStruct);

  /*Configure GPIO pins : PBPin PBPin PBPin */
  GPIO_InitStruct.Pin = SW_UP_Pin|SW_MENU_Pin|SW_DOWN_Pin;
  GPIO_InitStruct.Mode = GPIO_MODE_IT_FALLING;
  GPIO_InitStruct.Pull = GPIO_PULLUP;
  HAL_GPIO_Init(GPIOB, &GPIO_InitStruct);

  /*Configure GPIO pin : PtPin */
  GPIO_InitStruct.Pin = SW_LIGHT_Pin;
  GPIO_InitStruct.Mode = GPIO_MODE_IT_RISING_FALLING;
  GPIO_InitStruct.Pull = GPIO_NOPULL;
  HAL_GPIO_Init(SW_LIGHT_GPIO_Port, &GPIO_InitStruct);

  /*Configure GPIO pins : PH1 PH0 */
  GPIO_InitStruct.Pin = GPIO_PIN_1|GPIO_PIN_0;
  GPIO_InitStruct.Mode = GPIO_MODE_ANALOG;
  GPIO_InitStruct.Pull = GPIO_NOPULL;
  HAL_GPIO_Init(GPIOH, &GPIO_InitStruct);

  /*Configure GPIO pins : PBPin PBPin */
  GPIO_InitStruct.Pin = IMU_INT1_Pin|SW_RESET_Pin;
  GPIO_InitStruct.Mode = GPIO_MODE_INPUT;
  GPIO_InitStruct.Pull = GPIO_NOPULL;
  HAL_GPIO_Init(GPIOB, &GPIO_InitStruct);

  /*Configure GPIO pins : PCPin PCPin */
  GPIO_InitStruct.Pin = IMU_INT2_Pin|FG_INT_Pin;
  GPIO_InitStruct.Mode = GPIO_MODE_INPUT;
  GPIO_InitStruct.Pull = GPIO_NOPULL;
  HAL_GPIO_Init(GPIOC, &GPIO_InitStruct);

  /*Configure GPIO pin : PtPin */
  GPIO_InitStruct.Pin = LCD_REFRESH_Pin;
  GPIO_InitStruct.Mode = GPIO_MODE_OUTPUT_PP;
  GPIO_InitStruct.Pull = GPIO_PULLUP;
  GPIO_InitStruct.Speed = GPIO_SPEED_FREQ_LOW;
  HAL_GPIO_Init(LCD_REFRESH_GPIO_Port, &GPIO_InitStruct);

  /* EXTI interrupt init*/
  HAL_NVIC_SetPriority(EXTI3_IRQn, 0, 0);
  HAL_NVIC_EnableIRQ(EXTI3_IRQn);

  HAL_NVIC_SetPriority(EXTI9_5_IRQn, 0, 0);
  HAL_NVIC_EnableIRQ(EXTI9_5_IRQn);

  HAL_NVIC_SetPriority(EXTI15_10_IRQn, 0, 0);
  HAL_NVIC_EnableIRQ(EXTI15_10_IRQn);

}
