edwardatki/Quectowatch/STM32WB55/Firmware/Core/Inc/dseg7_mini_bold_26.h

/*
  Fontname: -FreeType-DSEG7 Classic Mini-Bold-R-Normal--36-260-100-100-P-198-ISO10646-1
  Copyright: Created by Keshikan  with FontForge 2.0 (http://fontforge.sf.net)
  Glyphs: 69/69
  BBX Build Mode: 1
*/
const uint8_t u8g2_font_dseg7_mini_bold_26_hf[3899] U8G2_FONT_SECTION("u8g2_font_dseg7_mini_bold_26_hf") = 
  "E\1\5\4\5\6\1\1\6\34$\376\0$\0$\0\2\311\10\336\17\36 \10\207\374\374\360G\0!"
  "\13\235\274\377\360\377\377\377\257\2-\24\235\274\377\360\377;\316=\20\332\3\301\271\17\377\77\3\0.\14"
  "\206\334\374\360\31\42\250!\6\0\60\134\235\274\77\17\204\366@pn\5\302\206\70\3\216C\34\71\244\225"
  "CZ\71\244\225CZ\71\244\225CZ\71\244\225C\34\71\3\216#\244\70\201\206\17\215@\303\21R\234"
  "\1\307!\216\34\322\312!\255\34\322\312!\255\34\322\312!\255\34\322\312!\216\234\1\307\21\203\15\261\234"
  "{ \264\7\202\1\61 \235\274\377\60)\364\310\4\327/\23=\266\340\341C\70l\241G&\270~\231"
  "\350\261\305\207\70\0\62\61\235\274\77\17\204\366@p\16\262!\364\310\4\327/\23=\266Xn\4\365@"
  "h\17\4\25\206[b\17M\62\375\345\241\305`\320\271\7B{ \30\0\63\62\235\274\77\17\204\366@"
  "p\16\262!\364\310\4\327/\23=\266Xn\4\365@h\17\4\347F\330B\217Lp\375\62\321\203\261"
  "!\226s\17\204\366@\60\0\64>\235\274\377P\17S\234\1\307!\216\34\322\312!\255\34\322\312!\255"
  "\34\322\312!\255\34\322\312!\216\234\1\307\21R\234\60\334\10\352\201\320\36\10\316\215\260\205\36\231\340\372"
  "e\242\307\26\37\342\0\65\61\235\274\77\17\204\366@pn\5\302\330\320$\323_\36Z\354\60\234{ "
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
  "=\266\340\341C#p\261\207&\231\376\362\320b\60\350\334\3\241=\20\14\0\260;\235\274\77\17\204\366"
  "@pn\5\302\206\70\3\216C\34\71\244\225CZ\71\244\225CZ\71\244\225CZ\71\244\225C\34\71"
  "\3\216#\244\70a\270\21\324\3\241=\20\234\373\360\377\63\0\0\0\0\4\377\377\0";
