edwardatki/Quectowatch/ESP32/Firmware/src/dseg7_classic_mini_bold_56.c

/*******************************************************************************
 * Size: 56 px
 * Bpp: 1
 * Opts: 
 ******************************************************************************/

#define LV_LVGL_H_INCLUDE_SIMPLE

#ifdef LV_LVGL_H_INCLUDE_SIMPLE
#include "lvgl.h"
#else
#include "lvgl/lvgl.h"
#endif

#ifndef DSEG7_CLASSIC_MINI_BOLD_56
#define DSEG7_CLASSIC_MINI_BOLD_56 1
#endif

#if DSEG7_CLASSIC_MINI_BOLD_56

/*-----------------
 *    BITMAPS
 *----------------*/

/*Store the image of the glyphs*/
static LV_ATTRIBUTE_LARGE_CONST const uint8_t glyph_bitmap[] = {
    /* U+0020 " " */
    0x0,

    /* U+0021 "!" */
    0x0,

    /* U+002D "-" */
    0x1f, 0xff, 0xfe, 0xf, 0xff, 0xff, 0xc7, 0xff,
    0xff, 0xfb, 0xff, 0xff, 0xff, 0x7f, 0xff, 0xff,
    0x8f, 0xff, 0xff, 0xc1, 0xff, 0xff, 0xe0,

    /* U+002E "." */
    0x38, 0xfb, 0xff, 0xff, 0xef, 0x8e, 0x0,

    /* U+0030 "0" */
    0x7, 0xff, 0xff, 0xfc, 0x1, 0xff, 0xff, 0xff,
    0xc0, 0x1f, 0xff, 0xff, 0xf0, 0x1, 0xff, 0xff,
    0xfc, 0x4, 0x1f, 0xff, 0xff, 0x5, 0xc1, 0xff,
    0xff, 0xc1, 0xfc, 0x1f, 0xff, 0xf0, 0x7f, 0xc0,
    0x0, 0x0, 0x1f, 0xfc, 0x0, 0x0, 0x7, 0xff,
    0xc0, 0x0, 0x1, 0xff, 0xf8, 0x0, 0x0, 0x3f,
    0xff, 0x0, 0x0, 0x7, 0xff, 0xe0, 0x0, 0x0,
    0xff, 0xfc, 0x0, 0x0, 0x1f, 0xff, 0x80, 0x0,
    0x3, 0xff, 0xf0, 0x0, 0x0, 0x7f, 0xfe, 0x0,
    0x0, 0xf, 0xff, 0xc0, 0x0, 0x1, 0xff, 0xf8,
    0x0, 0x0, 0x3f, 0xff, 0x0, 0x0, 0x7, 0xff,
    0xe0, 0x0, 0x0, 0xff, 0xf8, 0x0, 0x0, 0xf,
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
    0xfe, 0xe, 0xf, 0xff, 0xff, 0xe0, 0x83, 0xff,
    0xff, 0xfe, 0x0, 0xff, 0xff, 0xff, 0xe0, 0xf,
    0xff, 0xff, 0xf8, 0x0, 0xff, 0xff, 0xfe, 0x0,
    0xf, 0xff, 0xff, 0x80
};


/*---------------------
 *  GLYPH DESCRIPTION
 *--------------------*/

static const lv_font_fmt_txt_glyph_dsc_t glyph_dsc[] = {
    {.bitmap_index = 0, .adv_w = 0, .box_w = 0, .box_h = 0, .ofs_x = 0, .ofs_y = 0} /* id = 0 reserved */,
    {.bitmap_index = 0, .adv_w = 179, .box_w = 1, .box_h = 1, .ofs_x = 0, .ofs_y = 0},
    {.bitmap_index = 1, .adv_w = 731, .box_w = 1, .box_h = 1, .ofs_x = 0, .ofs_y = 0},
    {.bitmap_index = 2, .adv_w = 731, .box_w = 26, .box_h = 7, .ofs_x = 10, .ofs_y = 25},
    {.bitmap_index = 25, .adv_w = 0, .box_w = 7, .box_h = 7, .ofs_x = -3, .ofs_y = 0},
    {.bitmap_index = 32, .adv_w = 731, .box_w = 35, .box_h = 56, .ofs_x = 6, .ofs_y = 0},
    {.bitmap_index = 277, .adv_w = 731, .box_w = 7, .box_h = 48, .ofs_x = 33, .ofs_y = 4},
    {.bitmap_index = 319, .adv_w = 731, .box_w = 35, .box_h = 56, .ofs_x = 6, .ofs_y = 0},
    {.bitmap_index = 564, .adv_w = 731, .box_w = 30, .box_h = 56, .ofs_x = 10, .ofs_y = 0},
    {.bitmap_index = 774, .adv_w = 731, .box_w = 35, .box_h = 47, .ofs_x = 6, .ofs_y = 5},
    {.bitmap_index = 980, .adv_w = 731, .box_w = 35, .box_h = 56, .ofs_x = 6, .ofs_y = 0},
    {.bitmap_index = 1225, .adv_w = 731, .box_w = 35, .box_h = 56, .ofs_x = 6, .ofs_y = 0},
    {.bitmap_index = 1470, .adv_w = 731, .box_w = 35, .box_h = 52, .ofs_x = 6, .ofs_y = 4},
    {.bitmap_index = 1698, .adv_w = 731, .box_w = 35, .box_h = 56, .ofs_x = 6, .ofs_y = 0},
    {.bitmap_index = 1943, .adv_w = 731, .box_w = 35, .box_h = 56, .ofs_x = 6, .ofs_y = 0},
    {.bitmap_index = 2188, .adv_w = 179, .box_w = 7, .box_h = 30, .ofs_x = 2, .ofs_y = 12},
    {.bitmap_index = 2215, .adv_w = 731, .box_w = 35, .box_h = 52, .ofs_x = 6, .ofs_y = 5},
    {.bitmap_index = 2443, .adv_w = 731, .box_w = 35, .box_h = 52, .ofs_x = 6, .ofs_y = 0},
    {.bitmap_index = 2671, .adv_w = 731, .box_w = 30, .box_h = 32, .ofs_x = 6, .ofs_y = 0},
    {.bitmap_index = 2791, .adv_w = 731, .box_w = 35, .box_h = 52, .ofs_x = 6, .ofs_y = 0},
    {.bitmap_index = 3019, .adv_w = 731, .box_w = 30, .box_h = 56, .ofs_x = 6, .ofs_y = 0},
    {.bitmap_index = 3229, .adv_w = 731, .box_w = 30, .box_h = 52, .ofs_x = 6, .ofs_y = 5},
    {.bitmap_index = 3424, .adv_w = 731, .box_w = 35, .box_h = 56, .ofs_x = 6, .ofs_y = 0},
    {.bitmap_index = 3669, .adv_w = 731, .box_w = 35, .box_h = 47, .ofs_x = 6, .ofs_y = 5},
    {.bitmap_index = 3875, .adv_w = 731, .box_w = 7, .box_h = 22, .ofs_x = 33, .ofs_y = 4},
    {.bitmap_index = 3895, .adv_w = 731, .box_w = 35, .box_h = 52, .ofs_x = 6, .ofs_y = 0},
    {.bitmap_index = 4123, .adv_w = 731, .box_w = 35, .box_h = 52, .ofs_x = 6, .ofs_y = 5},
    {.bitmap_index = 4351, .adv_w = 731, .box_w = 30, .box_h = 52, .ofs_x = 6, .ofs_y = 0},
    {.bitmap_index = 4546, .adv_w = 731, .box_w = 35, .box_h = 52, .ofs_x = 6, .ofs_y = 4},
    {.bitmap_index = 4774, .adv_w = 731, .box_w = 35, .box_h = 27, .ofs_x = 6, .ofs_y = 5},
    {.bitmap_index = 4893, .adv_w = 731, .box_w = 35, .box_h = 32, .ofs_x = 6, .ofs_y = 0},
    {.bitmap_index = 5033, .adv_w = 731, .box_w = 35, .box_h = 52, .ofs_x = 6, .ofs_y = 5},
    {.bitmap_index = 5261, .adv_w = 731, .box_w = 35, .box_h = 52, .ofs_x = 6, .ofs_y = 5},
    {.bitmap_index = 5489, .adv_w = 731, .box_w = 30, .box_h = 27, .ofs_x = 6, .ofs_y = 5},
    {.bitmap_index = 5591, .adv_w = 731, .box_w = 35, .box_h = 52, .ofs_x = 6, .ofs_y = 0},
    {.bitmap_index = 5819, .adv_w = 731, .box_w = 30, .box_h = 52, .ofs_x = 6, .ofs_y = 0},
    {.bitmap_index = 6014, .adv_w = 731, .box_w = 35, .box_h = 27, .ofs_x = 6, .ofs_y = 0},
    {.bitmap_index = 6133, .adv_w = 731, .box_w = 35, .box_h = 52, .ofs_x = 6, .ofs_y = 0},
    {.bitmap_index = 6361, .adv_w = 731, .box_w = 35, .box_h = 52, .ofs_x = 6, .ofs_y = 0},
    {.bitmap_index = 6589, .adv_w = 731, .box_w = 35, .box_h = 47, .ofs_x = 6, .ofs_y = 5},
    {.bitmap_index = 6795, .adv_w = 731, .box_w = 35, .box_h = 52, .ofs_x = 6, .ofs_y = 0},
    {.bitmap_index = 7023, .adv_w = 731, .box_w = 35, .box_h = 56, .ofs_x = 6, .ofs_y = 0},
    {.bitmap_index = 7268, .adv_w = 731, .box_w = 26, .box_h = 7, .ofs_x = 10, .ofs_y = 0},
    {.bitmap_index = 7291, .adv_w = 731, .box_w = 35, .box_h = 52, .ofs_x = 6, .ofs_y = 5},
    {.bitmap_index = 7519, .adv_w = 731, .box_w = 35, .box_h = 52, .ofs_x = 6, .ofs_y = 0},
    {.bitmap_index = 7747, .adv_w = 731, .box_w = 30, .box_h = 32, .ofs_x = 6, .ofs_y = 0},
    {.bitmap_index = 7867, .adv_w = 731, .box_w = 35, .box_h = 52, .ofs_x = 6, .ofs_y = 0},
    {.bitmap_index = 8095, .adv_w = 731, .box_w = 30, .box_h = 56, .ofs_x = 6, .ofs_y = 0},
    {.bitmap_index = 8305, .adv_w = 731, .box_w = 30, .box_h = 52, .ofs_x = 6, .ofs_y = 5},
    {.bitmap_index = 8500, .adv_w = 731, .box_w = 35, .box_h = 56, .ofs_x = 6, .ofs_y = 0},
    {.bitmap_index = 8745, .adv_w = 731, .box_w = 35, .box_h = 47, .ofs_x = 6, .ofs_y = 5},
    {.bitmap_index = 8951, .adv_w = 731, .box_w = 7, .box_h = 22, .ofs_x = 33, .ofs_y = 4},
    {.bitmap_index = 8971, .adv_w = 731, .box_w = 35, .box_h = 52, .ofs_x = 6, .ofs_y = 0},
    {.bitmap_index = 9199, .adv_w = 731, .box_w = 35, .box_h = 52, .ofs_x = 6, .ofs_y = 5},
    {.bitmap_index = 9427, .adv_w = 731, .box_w = 30, .box_h = 52, .ofs_x = 6, .ofs_y = 0},
    {.bitmap_index = 9622, .adv_w = 731, .box_w = 35, .box_h = 52, .ofs_x = 6, .ofs_y = 4},
    {.bitmap_index = 9850, .adv_w = 731, .box_w = 35, .box_h = 27, .ofs_x = 6, .ofs_y = 5},
    {.bitmap_index = 9969, .adv_w = 731, .box_w = 35, .box_h = 32, .ofs_x = 6, .ofs_y = 0},
    {.bitmap_index = 10109, .adv_w = 731, .box_w = 35, .box_h = 52, .ofs_x = 6, .ofs_y = 5},
    {.bitmap_index = 10337, .adv_w = 731, .box_w = 35, .box_h = 52, .ofs_x = 6, .ofs_y = 5},
    {.bitmap_index = 10565, .adv_w = 731, .box_w = 30, .box_h = 27, .ofs_x = 6, .ofs_y = 5},
    {.bitmap_index = 10667, .adv_w = 731, .box_w = 35, .box_h = 52, .ofs_x = 6, .ofs_y = 0},
    {.bitmap_index = 10895, .adv_w = 731, .box_w = 30, .box_h = 52, .ofs_x = 6, .ofs_y = 0},
    {.bitmap_index = 11090, .adv_w = 731, .box_w = 35, .box_h = 27, .ofs_x = 6, .ofs_y = 0},
    {.bitmap_index = 11209, .adv_w = 731, .box_w = 35, .box_h = 52, .ofs_x = 6, .ofs_y = 0},
    {.bitmap_index = 11437, .adv_w = 731, .box_w = 35, .box_h = 52, .ofs_x = 6, .ofs_y = 0},
    {.bitmap_index = 11665, .adv_w = 731, .box_w = 35, .box_h = 47, .ofs_x = 6, .ofs_y = 5},
    {.bitmap_index = 11871, .adv_w = 731, .box_w = 35, .box_h = 52, .ofs_x = 6, .ofs_y = 0},
    {.bitmap_index = 12099, .adv_w = 731, .box_w = 35, .box_h = 56, .ofs_x = 6, .ofs_y = 0},
    {.bitmap_index = 12344, .adv_w = 731, .box_w = 35, .box_h = 32, .ofs_x = 6, .ofs_y = 25}
};

/*---------------------
 *  CHARACTER MAPPING
 *--------------------*/

static const uint16_t unicode_list_0[] = {
    0x0, 0x1, 0xd, 0xe
};

/*Collect the unicode lists and glyph_id offsets*/
static const lv_font_fmt_txt_cmap_t cmaps[] =
{
    {
        .range_start = 32, .range_length = 15, .glyph_id_start = 1,
        .unicode_list = unicode_list_0, .glyph_id_ofs_list = NULL, .list_length = 4, .type = LV_FONT_FMT_TXT_CMAP_SPARSE_TINY
    },
    {
        .range_start = 48, .range_length = 11, .glyph_id_start = 5,
        .unicode_list = NULL, .glyph_id_ofs_list = NULL, .list_length = 0, .type = LV_FONT_FMT_TXT_CMAP_FORMAT0_TINY
    },
    {
        .range_start = 65, .range_length = 26, .glyph_id_start = 16,
        .unicode_list = NULL, .glyph_id_ofs_list = NULL, .list_length = 0, .type = LV_FONT_FMT_TXT_CMAP_FORMAT0_TINY
    },
    {
        .range_start = 95, .range_length = 1, .glyph_id_start = 42,
        .unicode_list = NULL, .glyph_id_ofs_list = NULL, .list_length = 0, .type = LV_FONT_FMT_TXT_CMAP_FORMAT0_TINY
    },
    {
        .range_start = 97, .range_length = 26, .glyph_id_start = 43,
        .unicode_list = NULL, .glyph_id_ofs_list = NULL, .list_length = 0, .type = LV_FONT_FMT_TXT_CMAP_FORMAT0_TINY
    },
    {
        .range_start = 176, .range_length = 1, .glyph_id_start = 69,
        .unicode_list = NULL, .glyph_id_ofs_list = NULL, .list_length = 0, .type = LV_FONT_FMT_TXT_CMAP_FORMAT0_TINY
    }
};



/*--------------------
 *  ALL CUSTOM DATA
 *--------------------*/

#if LVGL_VERSION_MAJOR == 8
/*Store all the custom data of the font*/
static  lv_font_fmt_txt_glyph_cache_t cache;
#endif

#if LVGL_VERSION_MAJOR >= 8
static const lv_font_fmt_txt_dsc_t font_dsc = {
#else
static lv_font_fmt_txt_dsc_t font_dsc = {
#endif
    .glyph_bitmap = glyph_bitmap,
    .glyph_dsc = glyph_dsc,
    .cmaps = cmaps,
    .kern_dsc = NULL,
    .kern_scale = 0,
    .cmap_num = 6,
    .bpp = 1,
    .kern_classes = 0,
    .bitmap_format = 0,
#if LVGL_VERSION_MAJOR == 8
    .cache = &cache
#endif
};


/*-----------------
 *  PUBLIC FONT
 *----------------*/

/*Initialize a public general font descriptor*/
#if LVGL_VERSION_MAJOR >= 8
const lv_font_t dseg7_classic_mini_bold_56 = {
#else
lv_font_t dseg7_classic_mini_bold_56 = {
#endif
    .get_glyph_dsc = lv_font_get_glyph_dsc_fmt_txt,    /*Function pointer to get glyph's data*/
    .get_glyph_bitmap = lv_font_get_bitmap_fmt_txt,    /*Function pointer to get glyph's bitmap*/
    .line_height = 57,          /*The maximum line height required by the font*/
    .base_line = 0,             /*Baseline measured from the bottom of the line*/
#if !(LVGL_VERSION_MAJOR == 6 && LVGL_VERSION_MINOR == 0)
    .subpx = LV_FONT_SUBPX_NONE,
#endif
#if LV_VERSION_CHECK(7, 4, 0) || LVGL_VERSION_MAJOR >= 8
    .underline_position = -7,
    .underline_thickness = 3,
#endif
    .dsc = &font_dsc,          /*The custom font data. Will be accessed by `get_glyph_bitmap/dsc` */
    .fallback = NULL,
    .user_data = NULL
};



#endif /*#if DSEG7_CLASSIC_MINI_BOLD_56*/
