edwardatki/Quectowatch/STM32WB55/Firmware/Core/Inc/dseg7_mini_bold_13.h

/*
  Fontname: -FreeType-DSEG7 Classic Mini-Bold-R-Normal--18-130-100-100-P-102-ISO10646-1
  Copyright: Created by Keshikan  with FontForge 2.0 (http://fontforge.sf.net)
  Glyphs: 69/69
  BBX Build Mode: 1
*/
const uint8_t u8g2_font_dseg7_mini_bold_13_hf[1812] U8G2_FONT_SECTION("u8g2_font_dseg7_mini_bold_13_hf") = 
  "E\1\4\3\4\5\1\1\5\16\22\377\0\22\0\22\0\1L\4\31\6\367 \7$\247\217c\0!\10"
  "/\377\217\377\377\0-\13/\377\217\77:\274\307\37\1.\11#\237\217\215\204\4\0\60)/\377s "
  "\25q\21$'$'$'$'$'\24\31\217(\62HNHNHNHNHN(\342\42\352"
  "@\6\0\61\20/\377\17\34\255\347\361\310\243\365<\36\4\0\62\25/\377s w\21\255\347a\207g"
  "\341\322\272\216\270;\220\1\63\25/\377s w\21\255\347a\207\367\20\321zv\21u \3\64\34/"
  "\377\17\22\31$'$'$'$'$'\24\31vx\17\21\255\347\361 \0\65\27/\377s \25"
  "q&\255\353x\210\303{\210h=\273\210:\220\1\66!/\377s \25q&\255\353x\210\303\263\310"
  " \71!\71!\71!\71!\71\241\210\213\250\3\31\0\67\34/\377s \25q\21$'$'$'"
  "$'$'\24\31\217<Z\317\343A\0\70)/\377s \25q\21$'$'$'$'$'"
  "\24\31vx\26\31$'$'$'$'$'\24q\21u \3\71 /\377s \25q\21$"
  "'$'$'$'$'\24\31vx\17\21\255g\27Q\7\62\0:\15$\247\17\22#\22\17("
  "\42\17\2A'/\377s \25q\21$'$'$'$'$'\24\31vx\26\31$'$'"
  "$'$'$'\24\31\17\2B\37/\377\17\22.\255\353x\210\303\263\310 \71!\71!\71!\71"
  "!\71\241\210\213\250\3\31\0C\21/\377\217\77:<\13\227\326u\304\335\201\14\0D\35/\377\17\34"
  "\255\347a\207g\221ArBrBrBrBrB\21\27Q\7\62\0E\27/\377s \25q&"
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
  "\22\31$'$'$'$'$'\24\31vx\26\31$'$'$'$'$'\24\31\17\2"
  "y\36/\377\17\22\31$'$'$'$'$'\24\31vx\17\21\255g\27Q\7\62\0z\24"
  "/\377s w\21\255\347\361\210\302\245u\35qw \3\260\32/\377s \25q\21$'$'$"
  "'$'$'\24\31vx\217\77\2\0\0\0\4\377\377\0";
