edwardatki/Quectowatch/STM32WB55/Firmware/Core/Inc/delay.h

/*
 * delay.h
 *
 *  Created on: Aug 25, 2024
 *      Author: Ed
 */

#ifndef INC_DELAY_H_
#define INC_DELAY_H_

#include "main.h"

//void delay_ms(uint32_t tv) {
//	HAL_Delay(tv);
//}

#endif /* INC_DELAY_H_ */
