edwardatki/Quectowatch/NRF52/Firmware/tools/set_time.py

import time
import board
import busio
from adafruit_ds3231 import DS3231

i2c = busio.I2C(board.RTC_SCL, board.RTC_SDA)
rtc = DS3231(i2c)

rtc.datetime = time.struct_time((2024,10,01,21,28,45,1,9,-1))
