edwardatki/Quectowatch/(commit log)

2023-12-18 Start hardware
    [Hardware.kicad_pcb, Hardware.kicad_sch]
2023-12-21 Animation! And power saving tweaks
    Idle current is down to ~40ma at 25% brightness
2023-12-24 Schematic progress
    [Hardware.kicad_sch]
2023-12-29 Many things
    40ma at 25% brightness connected
    30ma at 25% brightness disconnected
2024-01-11 Hardware done and ordered 🤞
    [Hardware-CuBottom.gbr, Hardware-CuTop.gbr, Hardware-EdgeCuts.gbr, Hardware-MaskBottom.gbr, Hardware-MaskTop.gbr, Hardware-NPTH.drl, Hardware-PTH.drl, Hardware-PasteBottom.gbr]
2024-02-05 Start V2
    [Hardware-CuBottom.gbr, Hardware-CuTop.gbr, Hardware-EdgeCuts.gbr, Hardware-MaskBottom.gbr, Hardware-MaskTop.gbr, Hardware-NPTH.drl, Hardware-PTH.drl, Hardware-PasteBottom.gbr]
2024-02-09 Maybe I'll stick with ESP32-C3, nrf52 is proving a pain to work with
2024-02-14 Found a decent e-ink driver
2024-02-14 E-ink and BLE won't work at the same time :(
    [main.c]
2024-02-18 Just gonna use arduino for nrf52 version
2024-03-10 Start seperating eink driver into new file
2024-03-11 Update V1 schematic to e-ink
    [Hardware.kicad_sch]
2024-03-11 Rename V1 and V2 to ESP32 and NRF52
    [Hardware-CuBottom.gbr, Hardware-CuTop.gbr, Hardware-EdgeCuts.gbr, Hardware-MaskBottom.gbr, Hardware-MaskTop.gbr, Hardware-NPTH.drl, Hardware-PTH.drl, Hardware-PasteBottom.gbr]
2024-03-31 Progress on NRF52 version hardware
    [Hardware.kicad_pcb, Hardware.kicad_sch]
2024-04-01 Correct e-ink driver components
    [Hardware.kicad_pcb, Hardware.kicad_sch]
2024-04-03 NRF52 hardware as ordered
    [Hardware-CuBottom.gbr, Hardware-CuTop.gbr, Hardware-EdgeCuts.gbr, Hardware-MaskBottom.gbr, Hardware-MaskTop.gbr, Hardware-NPTH.drl, Hardware-PTH.drl, Hardware-PasteBottom.gbr]
2024-04-03 Fix timezones on ESP32 version
    [gadgetbridge.c]
2024-04-19 Start circuitpython version of software
    [Hardware.kicad_sch, Hardware.step]
2024-04-20 Add missing files and start on button input
    [button_test.py, buttons.py, code.py, set_time.py]
2024-07-22 Miscellaneous small software improvements
    [Hardware.kicad_pcb]
2024-08-02 Start STM32WB version schematic
    [Hardware.kicad_pcb, Hardware.kicad_sch]
2024-08-12 Schematic progress and start PCB
    [Hardware.kicad_pcb, Hardware.kicad_sch, Hardware.step]
2024-08-24 Start STM32WB firmware
    [case.step, cover.step]
2024-08-27 Set all unused pins to analog to save power
2024-08-29 RTC calibration and button debouncing
2024-10-06 Fix day of week crashing on Mondays and set terminate voltage on fuel gauge
    [lcd.h, main.c, set_time.py]
