edwardatki/Quectowatch/(notices)

Notices in the files:
STM32WB55/Firmware/Core/Src/gpio.c:
Copyright (c) 2024 STMicroelectronics.
All rights reserved.
This software is licensed under terms that can be found in the LICENSE file
